fadedfan/Prony-Brake-Dynamometer/Firmware/Firmware/README_TUNING.pdf

# README – Reading and tuning the data

Team Cambot (Brandon Bravo, Miguel Jiminez Gomez, Shifan Liu, Hayden Webb)

Reading Data from Arduino

Steps to Upload Code and Read Data from Arduino

To upload the provided code to the Arduino UNO and set up the Serial Monitor to read data from the Arduino and tune the data, follow these steps:

1. Select the Correct Board and Port
2. Upload the Code to the Arduino
3. Open the Serial Monitor
4. Set the Serial Monitor Baud Rate (115200)
5. Monitor the Data

Once the Serial Monitor is open and the correct baud rate is set, you should start seeing data printed on the screen. This will include the RPM, torque, and current readings from the sensors connected to the Arduino, based on the mode you select (RPM or Torque/Current).

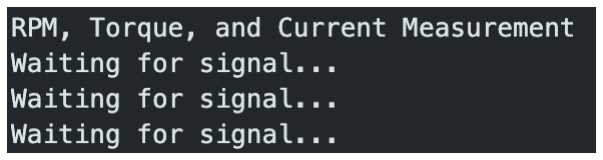
[picture p2: figure]

You can input commands (e.g., r for RPM, t for Torque/Current) directly into the Serial Monitor’s input box at the top and press Enter to switch between modes and see corresponding data.

If the input is r (RPM):

If the input is t (Torque/Current):

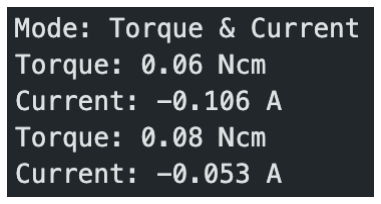
[picture p3: figure]

1

Instructions to Adjust Calibration Values for Load Cell and ACS712

To ensure accurate readings from your load cell (HX711) and current sensor (ACS712), it's essential to calibrate and adjust the MULTIPLIER value based on real reference measurements. Follow these steps to perform this adjustment:

Steps for adjusting the Load Cell Calibration (MULTIPLIER)

1. Prepare a Known accurate motor
2. Upload the Code
3. Open the Serial Monitor
4. Fix the known motor and the shaft on the Load Cell
5. Start the motor and observe the output

Copy the Data from the Serial Monitor over a period of time while the system is running. Alternatively, users can use a serial data logger (like the Arduino Serial Plotter or external logging software) to log this data to a file.

Depending on your system, users may expect a linear relationship between output torque and actual torque from the supplier. Users can fit a linear regression line to the data points to compare the actual behavior with the expected linear model.

Example data from MN5006 Antigravity Type 4-6S UAV Motor KV450:

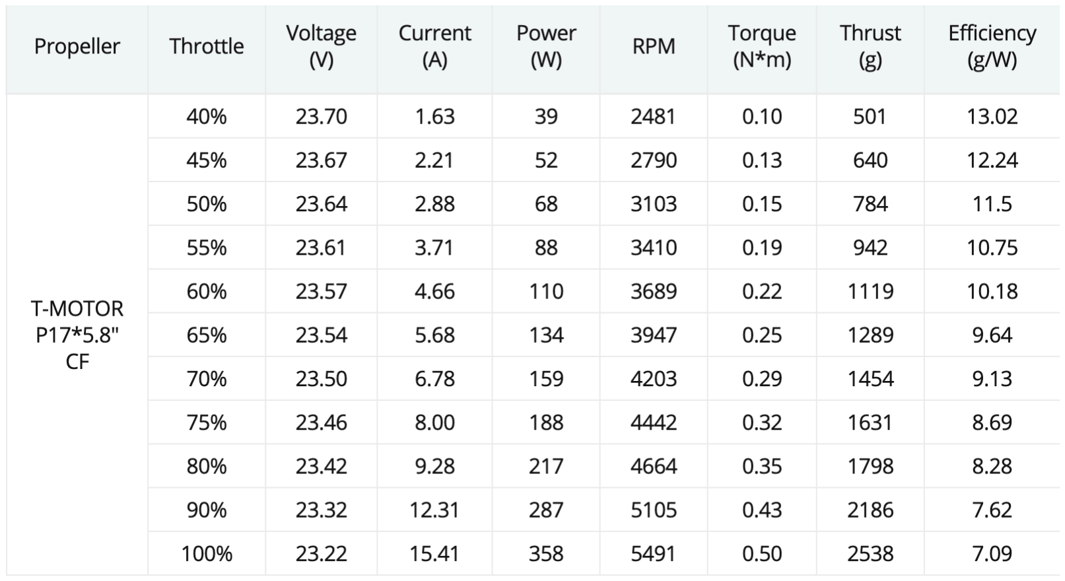
[picture p4: figure]

With the same current implemented on the motor, check the multiplier between the output torque from the dynamometer and the torque from a reliable source.
